XFactHD/TS3-Display/Hardware/v2/TS3Display.kicad_pcb

## KiCad design Hardware/v2/TS3Display.kicad_pcb (2021-09-24)

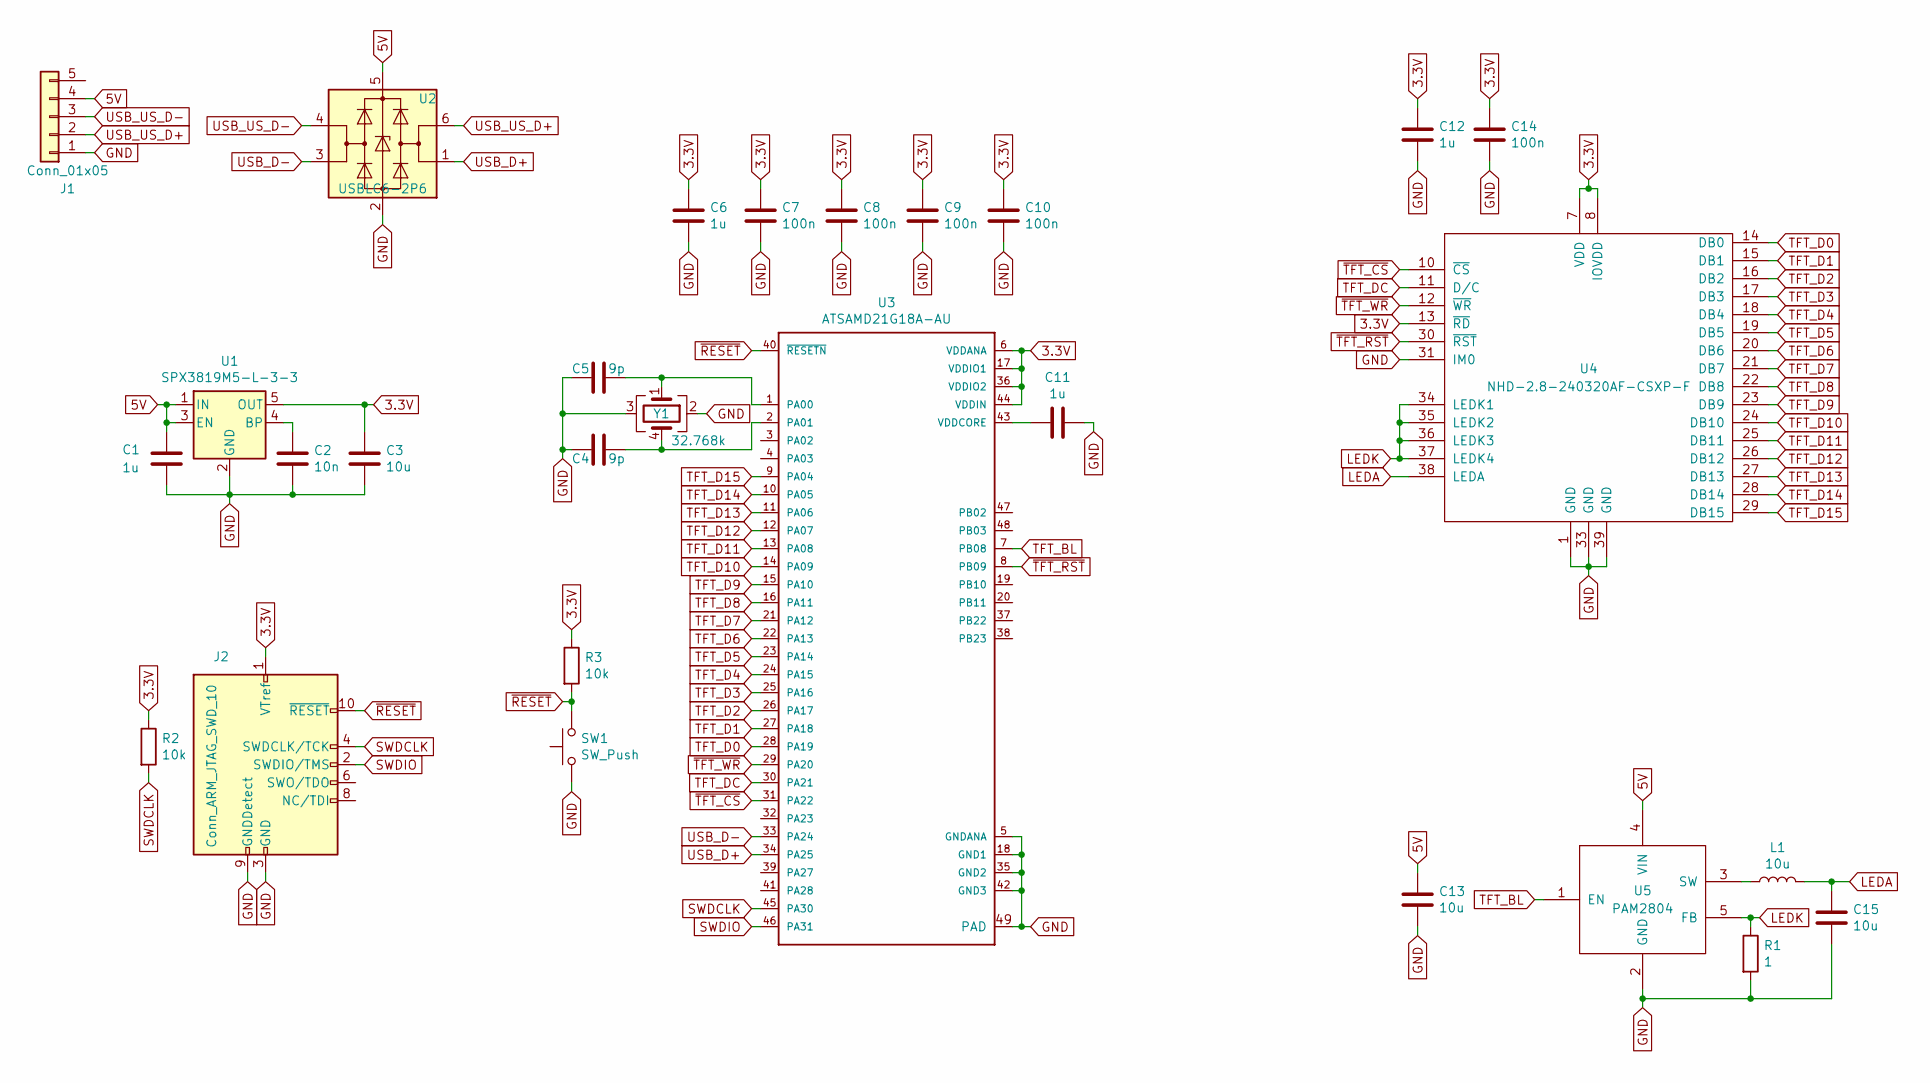
[picture p1: schematic TS3Display.sch]

Parts:
C1, C6, C11, C12: 1u; C_0805
C2: 10n; C_0805
C3, C13, C15: 10u; C_0805
C4, C5: 9p; C_0805
C7: 100n; C_0603
C8, C9, C10, C14: 100n; C_0805
J1: Conn_01x05; JST_SH_BM05B-SRSS-TB_05x1.00mm_Straight
J2: Conn_ARM_JTAG_SWD_10; Pin_Header_Straight_2x05_Pitch1.27mm_SMD
L1: 10u; L_Taiyo-Yuden_NR-40xx
R1: 1; R_0805
R2, R3: 10k; R_0805
SW1: SW_Push; SW_SPST_PTS810
U1: SPX3819M5-L-3-3; SOT-23-5
U2: USBLC6-2P6; SOT-23-6
U3: ATSAMD21G18A-AU; QFN-48-1EP_7x7mm_Pitch0.5mm
U4: NHD-2.8-240320AF-CSXP-F
U5: PAM2804; TSOT-23-5
Y1: 32.768k; Crystal_SMD_SeikoEpson_MC146-4pin_6.7x1.5mm

Connections:
3.3V: C3.1, C6.1, C7.1, C8.1, C9.1, C10.1, C12.1, C14.1, J2.1 (VTref), R2.1, R3.1, U1.5 (OUT), U3.6 (VDDANA), U3.17 (VDDIO1), U3.36 (VDDIO2), U3.44 (VDDIN), U4.7 (VDD), U4.8 (IOVDD), U4.13 (~RD)
5V: C1.1, C13.2, J1.4, U1.1 (IN), U1.3 (EN), U2.5 (VBUS), U5.4 (VIN)
GND: C1.2, C2.1, C3.2, C4.2, C5.2, C6.2, C7.2, C8.2, C9.2, C10.2, C11.1, C12.2, C13.1, C14.2, C15.1, J1.1, J2.3 (GND), J2.5 (GND), J2.9 (GNDDetect), R1.2, SW1.1, U1.2 (GND), U2.2 (GND), U3.5 (GNDANA), U3.18 (GND1), U3.35 (GND2), U3.42 (GND3), U3.49 (PAD), U4.1 (GND), U4.31 (IM0), U4.33 (GND), U4.39 (GND), U5.2 (GND), Y1.2, Y1.3
LEDA: C15.2, L1.2, U4.38 (LEDA)
LEDK: R1.1, U4.34 (LEDK1), U4.35 (LEDK2), U4.36 (LEDK3), U4.37 (LEDK4), U5.5 (FB)
unnamed: C2.2, U1.4 (BP)
unnamed: C4.1, U3.2 (PA01), Y1.4
unnamed: C5.1, U3.1 (PA00), Y1.1
unnamed: C11.2, U3.43 (VDDCORE)
unnamed: L1.1, U5.3 (SW)
SWDCLK: J2.4 (SWDCLK/TCK), R2.2, U3.45 (PA30)
SWDIO: J2.2 (SWDIO/TMS), U3.46 (PA31)
TFT_BL: U3.7 (PB08), U5.1 (EN)
TFT_D0: U3.28 (PA19), U4.14 (DB0)
TFT_D1: U3.27 (PA18), U4.15 (DB1)
TFT_D2: U3.26 (PA17), U4.16 (DB2)
TFT_D3: U3.25 (PA16), U4.17 (DB3)
TFT_D4: U3.24 (PA15), U4.18 (DB4)
TFT_D5: U3.23 (PA14), U4.19 (DB5)
TFT_D6: U3.22 (PA13), U4.20 (DB6)
TFT_D7: U3.21 (PA12), U4.21 (DB7)
TFT_D8: U3.16 (PA11), U4.22 (DB8)
TFT_D9: U3.15 (PA10), U4.23 (DB9)
TFT_D10: U3.14 (PA09), U4.24 (DB10)
TFT_D11: U3.13 (PA08), U4.25 (DB11)
TFT_D12: U3.12 (PA07), U4.26 (DB12)
TFT_D13: U3.11 (PA06), U4.27 (DB13)
TFT_D14: U3.10 (PA05), U4.28 (DB14)
TFT_D15: U3.9 (PA04), U4.29 (DB15)
TFT_DC: U3.30 (PA21), U4.11 (D/C)
USB_D+: U2.1 (I/O1), U3.34 (PA25)
USB_D-: U2.3 (I/O2), U3.33 (PA24)
USB_US_D+: J1.2, U2.6 (I/O1)
USB_US_D-: J1.3, U2.4 (I/O2)
~RESET: J2.10 (~RESET~), R3.2, SW1.2, U3.40 (~RESETN~)
~TFT_CS: U3.31 (PA22), U4.10 (~CS)
~TFT_RST: U3.8 (PB09), U4.30 (~RST)
~TFT_WR: U3.29 (PA20), U4.12 (~WR)

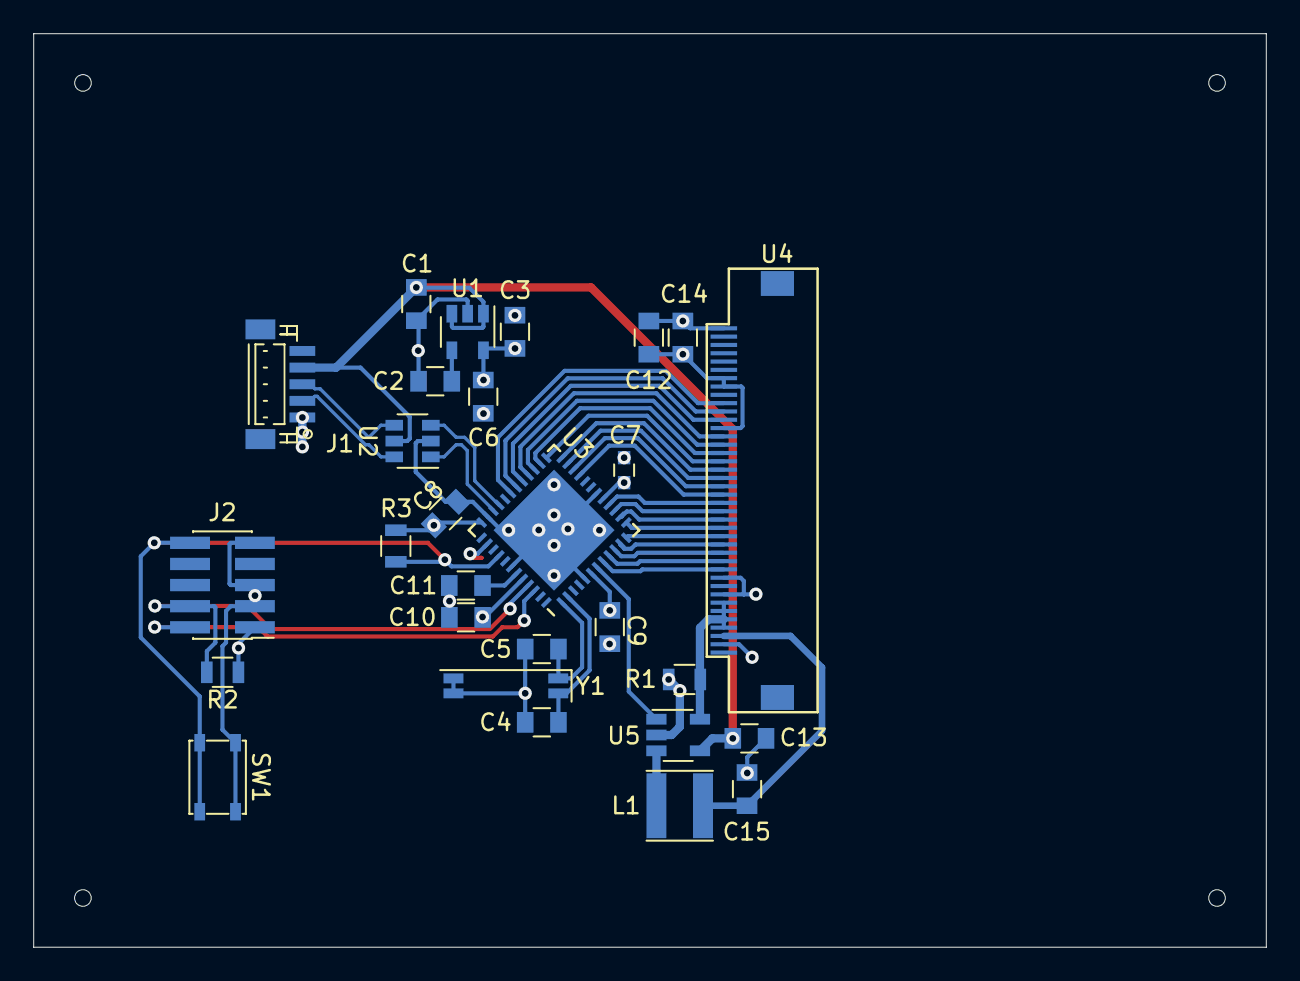
[picture p2: board TS3Display.kicad_pcb from below]

Board: 4 copper layers, 74.1 x 54.9 mm, 28 parts (27 on the bottom side), 38 nets.
