XFactHD/TS3-Display/Firmware/v2/include/icons.hpp

#ifndef ICONS_HPP
#define ICONS_HPP

#include <Arduino.h>

#define ICON_SILENT 0
#define ICON_TALKING 1
#define ICON_MIC_MUTED 2
#define ICON_SOUND_MUTED 3
#define ICON_AWAY 4

const PROGMEM uint16_t icons[5][16*16] {
    { //Silent
        0xFFFF, 0xFFFF, 0xFFFF, 0xFFFF, 0xFFFF, 0xFFFF, 0xFFFF, 0xFFFF, 0xFFFF, 0xFFFF, 0xFFFF, 0xFFFF, 0xFFFF, 0xFFFF, 0xFFFF, 0xFFFF,
        0xFFFF, 0xFFFF, 0xFFFF, 0xFFFF, 0x001F, 0x001F, 0x001F, 0x001F, 0x001F, 0x001F, 0x001F, 0x001F, 0xFFFF, 0xFFFF, 0xFFFF, 0xFFFF,
        0xFFFF, 0xFFFF, 0x001F, 0x001F, 0x000F, 0x000F, 0x000F, 0x000F, 0x000F, 0x000F, 0x000F, 0x000F, 0x001F, 0x001F, 0xFFFF, 0xFFFF,
        0xFFFF, 0xFFFF, 0x001F, 0x000F, 0x000F, 0x000F, 0x000F, 0x000F, 0x000F, 0x000F, 0x000F, 0x000F, 0x000F, 0x001F, 0xFFFF, 0xFFFF,
        0xFFFF, 0x001F, 0x000F, 0x000F, 0x000F, 0x000F, 0x000F, 0x000F, 0x000F, 0x000F, 0x000F, 0x000F, 0x000F, 0x000F, 0x001F, 0xFFFF,
        0xFFFF, 0x001F, 0x000F, 0x000F, 0x000F, 0x000F, 0x000F, 0x000F, 0x000F, 0x000F, 0x000F, 0x000F, 0x000F, 0x000F, 0x001F, 0xFFFF,
        0xFFFF, 0x001F, 0x000F, 0x000F, 0x000F, 0x000F, 0x000F, 0x000F, 0x000F, 0x000F, 0x000F, 0x000F, 0x000F, 0x000F, 0x001F, 0xFFFF,
        0xFFFF, 0x001F, 0x000F, 0x000F, 0x000F, 0x000F, 0x000F, 0x000F, 0x000F, 0x000F, 0x000F, 0x000F, 0x000F, 0x000F, 0x001F, 0xFFFF,
        0xFFFF, 0x001F, 0x000F, 0x000F, 0x000F, 0x000F, 0x000F, 0x000F, 0x000F, 0x000F, 0x000F, 0x000F, 0x000F, 0x000F, 0x001F, 0xFFFF,
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
        0xFFFF, 0xFFFF, 0xFFFF, 0xFFFF, 0xFFFF, 0xFFFF, 0xFFFF, 0xFFFF, 0xFFFF, 0xFFFF, 0xFFFF, 0xFFFF, 0xFFFF, 0xFFFF, 0xFFFF, 0xFFFF
    }
};

#endif //ICONS_HPP
