XFactHD/TS3-Display/Firmware/v2/include/cmd.hpp

#ifndef CMD_HPP
#define CMD_HPP

#include <Arduino.h>

#define MAX_STR_LEN 35

#define CMD_CONNECT           0x10  // We connected to a server (own userId)
#define CMD_DISCONNECT        0x11  // We left the server (no args)
#define CMD_SERVER_NAME       0x20  // New servers name (server name)
#define CMD_CHANNEL_SWITCH    0x30  // We switch channel (channel name)
#define CMD_CHANNEL_JOIN      0x31  // Someone joined our channel (userId, state, user name)
#define CMD_CHANNEL_APPEND    0x32  // Someone who is already in our channel, can now be shown on the display
#define CMD_CHANNEL_LEAVE     0x33  // Someone left our channel (userId)
#define CMD_CLIENT_NAME       0x40  // Used for clients in new channel after channel switch (userId, state, user name)
#define CMD_CLIENT_TALK       0x41  // Someone starts/stops speaking (userId, status)
#define CMD_CLIENT_MIC_MUTE   0x42  // Someone muted/unmuted their mic (userId, status)
#define CMD_CLIENT_SOUND_MUTE 0x43  // Someone muted/unmuted their sound (userId, status)
#define CMD_CLIENT_AWAY		  0x44	// Someone went away or came back (userId, status)
#define CMD_CLIENT_RENAME     0x45  // Someone changed their name
#define CMD_DISP_ON           0x50  // Switch display backlight on
#define CMD_DISP_OFF          0x51  // Switch display backlight off
#define CMD_CHECK_INTEGRITY   0x52	// Check integrity of the data on the display
#define CMD_REBUILD_LIST	  0x53	// Clear the client list on the display for rebuilding
#define CMD_REBUILD_DONE	  0x54	// Rebuild done, trigger redraw
#define CMD_CONFIG            0x55  // Set configuration
#define CMD_ACK               0x60  // Command acknowledge

#define CONFIG_DARK_MODE      0x01
#define CONFIG_BRIGHTNESS     0x02

//Must be marked as packed on 32bit processors because the compiler adds padding leading to a size of 48 instead of 44
typedef struct __attribute__((packed)) {
    uint8_t cmdID;
    uint16_t userID;
    uint32_t talkPower;
    uint8_t state;
    char data[MAX_STR_LEN + 1];
} cmd_t;

#endif //CMD_HPP
