XFactHD/TS3-Display/(commit log)

2020-12-18 Initial commit with Hardware and Firmware
    [TS3Display.kicad_pcb, TS3Display.sch]
2021-02-15 Fix string copy crash in name sanitizer, cleanup logging, implement connection timeout
    [cmd.hpp, main.cpp]
2021-03-05 Use different connector for USB connection
    [TS3Display.kicad_pcb, TS3Display.sch]
2021-04-12 Fix crystal connections
    [TS3Display.kicad_pcb, TS3Display.sch]
2021-08-02 Fix mirrored LCD FPC pinout
    [TS3Display.kicad_pcb, TS3Display.sch]
2021-09-24 Add missing IM0 pin to display and tie to ground, fixes display not initializing
    [TS3Display.kicad_pcb, TS3Display.sch]
